damienmaguire/Nissan-Leaf-Inverter-Controller/Leaf_Inv_Controller_V1_BOM.ods

Nissan Leaf Inverter Controller V1 BOM
Ref Name | Qty | Component | Value | Manufacturer | MPN | RS Part Number | Mouser Part Number | Description
D3,4,5,6 | 4 | 1N4148WS-7-F |  | Diodes Inc. | 1N4148WS-7-F | 9228070 |  | Diode Switching 150mA 75V 200mW SOD323 Diodes Inc 1N4148WS-7-F Switching Diode, 150mA 75V, 2-Pin SOD-323
CONN3,5 | 2 | 3WAY_SIL |  | AMPHENOL FCI | 77311-401-36LF | 771-0189 |  | Board-To-Board Connector, 2.54 mm, 36 Contacts, Header, BergStik 77311 Series, Through Hole, 1 Rows
CONN1 | 1 | 75867-101LF |  | 75867101LF | FCI | 75867-101LF | 6737635 | 10w R/A T/H boxed header Quickie Amphenol FCI Quickie Series, 2.54mm Pitch 10 Way 2 Row Shrouded Right Angle PCB Header, Through Hole
CONN2 | 1 | 5787834-1 |  | TE Connectivity | 5787834-1 | 5298224 |  | USB type B vertical thru-hole socket
CONN4 | 1 | Cinch |  | Cinch | 5810132011 |  | 538-581-01-32-011 | Automotive Connectors MODICE ME-MX 32 POSITION
L1 | 1 | 7447709470 |  | Wurth Elektronik | 7447709470 | 789-6805 |  | Surface Mount Power Inductor, WE-PD Series, 47 µH, 3.8 A, 4.5 A, Shielded, 0.06 ohm
IC1 | 1 | ATSAM3X/AAU | ATSAM3X8EA-AU | Microchip | ATSAM3X8EA-AU | 131-1191 | 556-ATSAM3X8EA-AU | ATSAM3X8EA-AU, 32bit ARM Cortex M3 Microcontroller, 84MHz, 512 kB Flash, 144-Pin LQFP
C2,4,5,6,7,8,9,11,14,15,16,18,19,20,21,22,23,32,106,107,65 | 21 | C-USC0805 | 0.1u | MURATA | GRM219R71C104KA01D | 790-0667 |  | 100nF Multilayer Ceramic Capacitor MLCC 16V dc ±10% X7R Dielectric 0805 (2012M)
C30 | 1 | C-USC0805 | 0.01u | AVX | 08055F103KAT2A | 698-3462 |  | 10nF Multilayer Ceramic Capacitor MLCC 50V dc ±10% X8R Dielectric 0805 (2012M)
C113,66,111,112,67,36,37,17 | 8 | C-USC0805 | 1uF | KEMET | C0805C105K4RACTU | 451-5770 |  | 1μF Multilayer Ceramic Capacitor MLCC 16V dc ±10% X7R Dielectric 0805 (2012M)
C1,10,12,13,24,31 | 6 | C-USC0805 | 10u | MURATA | GRM21BR61E106KA73L | 790-0673 |  | 10μF Multilayer Ceramic Capacitor MLCC 25V dc ±10% X5R Dielectric 0805 (2012M)
C27,28,29 | 3 | C-USC0805 | 22p | AVX | 08051A220JAT2A | 464-6587 |  | 22pF Multilayer Ceramic Capacitor MLCC 100V dc ±5% C0G Dielectric 0805 (2012M)
C105,108 | 2 | C-USC0805 | 47nF | AVX | 08055F473KAT2A | 698-3516 |  | 47nF Multilayer Ceramic Capacitor MLCC 50V dc ±10% X8R Dielectric 0805 (2012M)
C25,26 | 2 | C-USC1206 | 22p | AVX | 12061A220JAT2A | 136-4302 |  | AVX 22pF Multilayer Ceramic Capacitor (MLCC) 100V dc ±5% 1206 (3216M)
C3 | 1 | Cap_el | 100uF | RSPRO | 711-0703 | 711-0703 |  | Aluminium Electrolytic Capacitor 100μF 6.3V dc 5mm Through Hole
Y1 | 1 | CRYSTAL-3.2-2.5 | 12MHz KX-7 20pF | ECS | ECS-120-20-33-CKM-TR |  | 520-120-20-33-CKMT | Crystals 12.000MHz 20pF 10ppm -20C +70C
C38 | 1 | ECA1AAD221X | 220uF 10V | Panasonic | ECA1AAD221X | 7270786P |  | Panasonic 220uF 10V dc Aluminium Electrolytic Capacitor, Through Hole 8 (Dia.) x 5mm +85C 8mm 0.5mm
C35 | 1 | EEU-FM1E681 | 680uF 35V | Panasonic | EEU-FM1E681 |  |  | PANASONIC ELECTRONIC COMPONENTS - EEU-FM1E681 - \94DD\7535\89E3\7535\5BB9, 680UF, 25V, \5F84\5411\5F15\7EBF
S1,S2 | 2 | EVQPE505K |  | Panasonic | EVQPE505K | 7561565 |  | Tact switch,THT,SPST,black,1.6N op force Black Push Plate Tactile Switch, SPST-NO 50 mA 5mm
LD1 | 1 | LD1117SOT223 | LD1117-3.3 | STMICROELECTRONICS | LD1117S33CTR | 686-9388 |  | LD1117S33CTR, LDO Regulator, 1.3A, 3.3 V, ±1% 3+Tab-Pin, SOT-223
LED1,2 | 1 | LED0805 |  | Wurth Elektronik | 150080SS75000 | 815-4234 |  | Wurth Elektronik 150080SS75000, WL-SMCW 630 nm Red LED, 2012 (0805) Clear SMD package
IC6 | 1 | LM2596S-5.0_NOPB |  | Texas Instruments | LM2596S-5.0/NOPB | 5333692 |  | SIMPLE SWITCHER 4.5V to 40V, 3A Low Component Count Step-Down Regulator
IC7 | 1 | M24M02-DRMN6TP |  | STMicroelectronics | M24M02-DRMN6TP | 8805333 |  | STMicroelectronics M24M02-DRMN6TP EEPROM Memory, 2Mbit, 450ns, 1.8 5.5 V 8-Pin SOIC
D1,2 | 1 | MBRS540T3G |  | ON Semiconductor | MBRS540T3G | 1250012 |  | Diode Schottky 40V 5A SMC ON Semiconductor MBRS540T3G Schottky Diode, 5A, 40V, 2-Pin SMC
IC5,IC8,IC9 | 3 | NCV8401ADTRKG |  | ON Semiconductor | NCV8401ADTRKG | 8079877 |  | Power Load Distribution Switch IC, Low Side, 1 Output, ± 14 V in, 16 A, 0.034 ohm
R73,74,75,76 | 4 | R-US_R0805 | 1K | RSPRO | 804-6449 | 804-6449 |  | Thick Film Surface Mount Fixed Resistor 0805 Case 1kΩ ±1% 0.125W
R15,17,23 | 3 | R-US_R0805 | 1K5 | RSPRO | RS-0805-1k5 | 713-6954 |  | Thick Film Surface Mount Fixed Resistor 0805 Case 1.5kΩ ±5% 0.125W
R6 | 1 | R-US_R0805 | 2K7 | RSPRO | 804-6486 | 804-6486 |  | Thick Film Surface Mount Fixed Resistor 0805 Case 2.7kΩ ±1% 0.125W
R14,16,18,19,22 | 5 | R-US_R0805 | 4K7 | RSPRO | RS-0805-4k7 | 713-6998 |  | Thick Film Surface Mount Fixed Resistor 0805 Case 4.7kΩ ±5% 0.125W
R4 | 1 | R-US_R0805 | 6k8 1% | RSPRO | 804-6515 | 804-6515 |  | Thick Film Surface Mount Fixed Resistor 0805 Case 6.8kΩ ±1% 0.125W
R8 | 1 | R-US_R0805 | 22K | RSPRO | 804-6546 | 804-6546 |  | Thick Film Surface Mount Fixed Resistor 0805 Case 22kΩ ±1% 0.125W
R2,3 | 2 | R-US_R0805 | 39R | RSPRO | 804-6335 | 804-6335 |  | Thick Film Surface Mount Fixed Resistor 0805 Case 39Ω ±1% 0.125W
R69,70,71,72 | 4 | R-US_R0805 | 60R4 | RSPRO | RS-0805-60R4 | 717-2130 |  | Thick Film Surface Mount Fixed Resistor 0805 Case 60.4Ω ±1% 0.125W
R1 | 1 | R-US_R0805 | 100k | RSPRO | 804-6607 | 804-6607 |  | Thick Film Surface Mount Fixed Resistor 0805 Case 100kΩ ±1% 0.125W
R5,13 | 2 | R-US_R0805 | 390R | RSPRO | RS-0805-390R | 713-6907 |  | Thick Film Surface Mount Fixed Resistor 0805 Case 390Ω ±5% 0.125W
Y2 | 1 | RESONATOR_EPSON_FC_145 | 32.768Khz | EPSON TOYOCOM | FC-135 32.768KHz 20ppm, 7pF | 667-6094 |  | SMD Crystal 32.768kHz, ±20ppm, 2-Pin, 3.2 x 1.5 x 0.8mm
IC3,4 | 2 | SN65HVD234 | SN65HVD234 | Texas Instruments | SN65HVD234D | 662-4315 |  | SN65HVD234D, CAN Transceiver 1MBps 1-channel ISO 11898
R20,21 | 1 | VARISTORCN0603 | CG0603MLC-05E | Bourns | CG0603MLC-05E | 851-8256 |  | MLC Series Power Varistor 0.5pF, Clamping 20V 0603 (1608M)
L2,3,4,5 | 4 | WE-CBF_0805 | MH2029-300Y | Bourns | MH2029-300Y |  | 652-MH2029-300Y | Ferrite Beads 30 ohms 25% HIGH CURRENT
Cinch Enclosure | 1 |  |  | Cinch | 5810130065 |  | 538-581-01-30-065 | Connector Accessory, Enclosure, Cinch ModICE SE Series Modular Connector Enclosures
