damienmaguire/Nissan-Leaf-Inverter-Controller/Leaf_VCU_V1 - Schematic.pdf

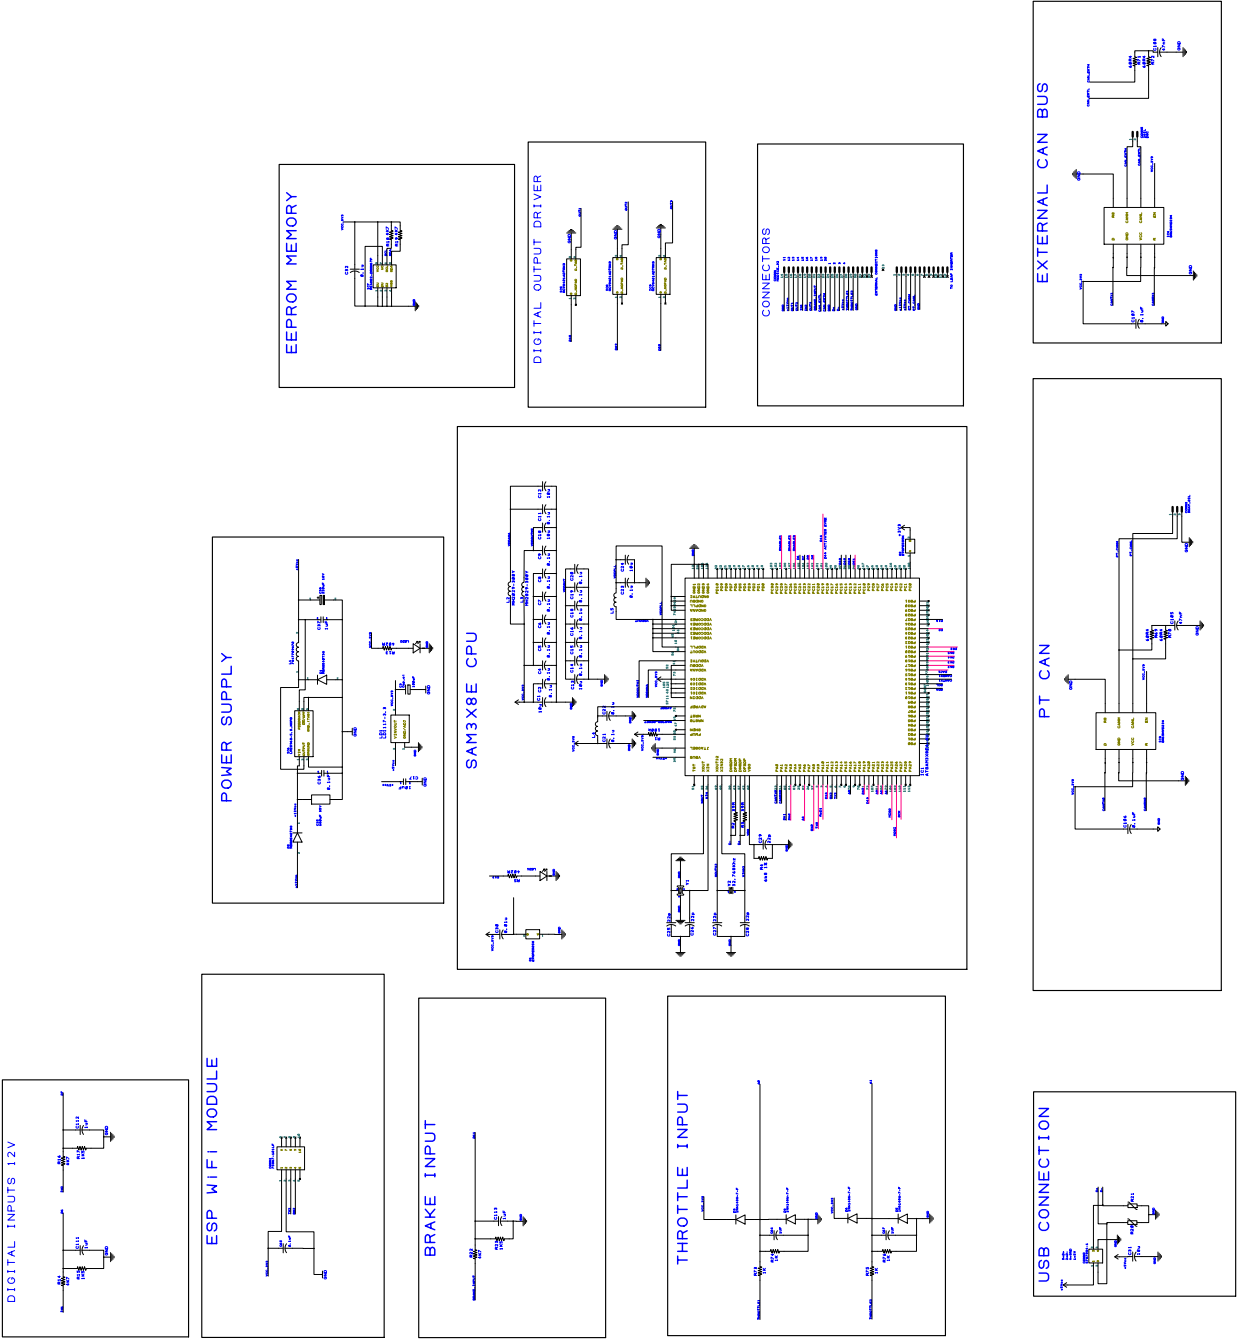
[picture p1: page 1]
