damienmaguire/Nissan-Leaf-Inverter-Controller/Leaf_VCU_V1 - PCB.pdf

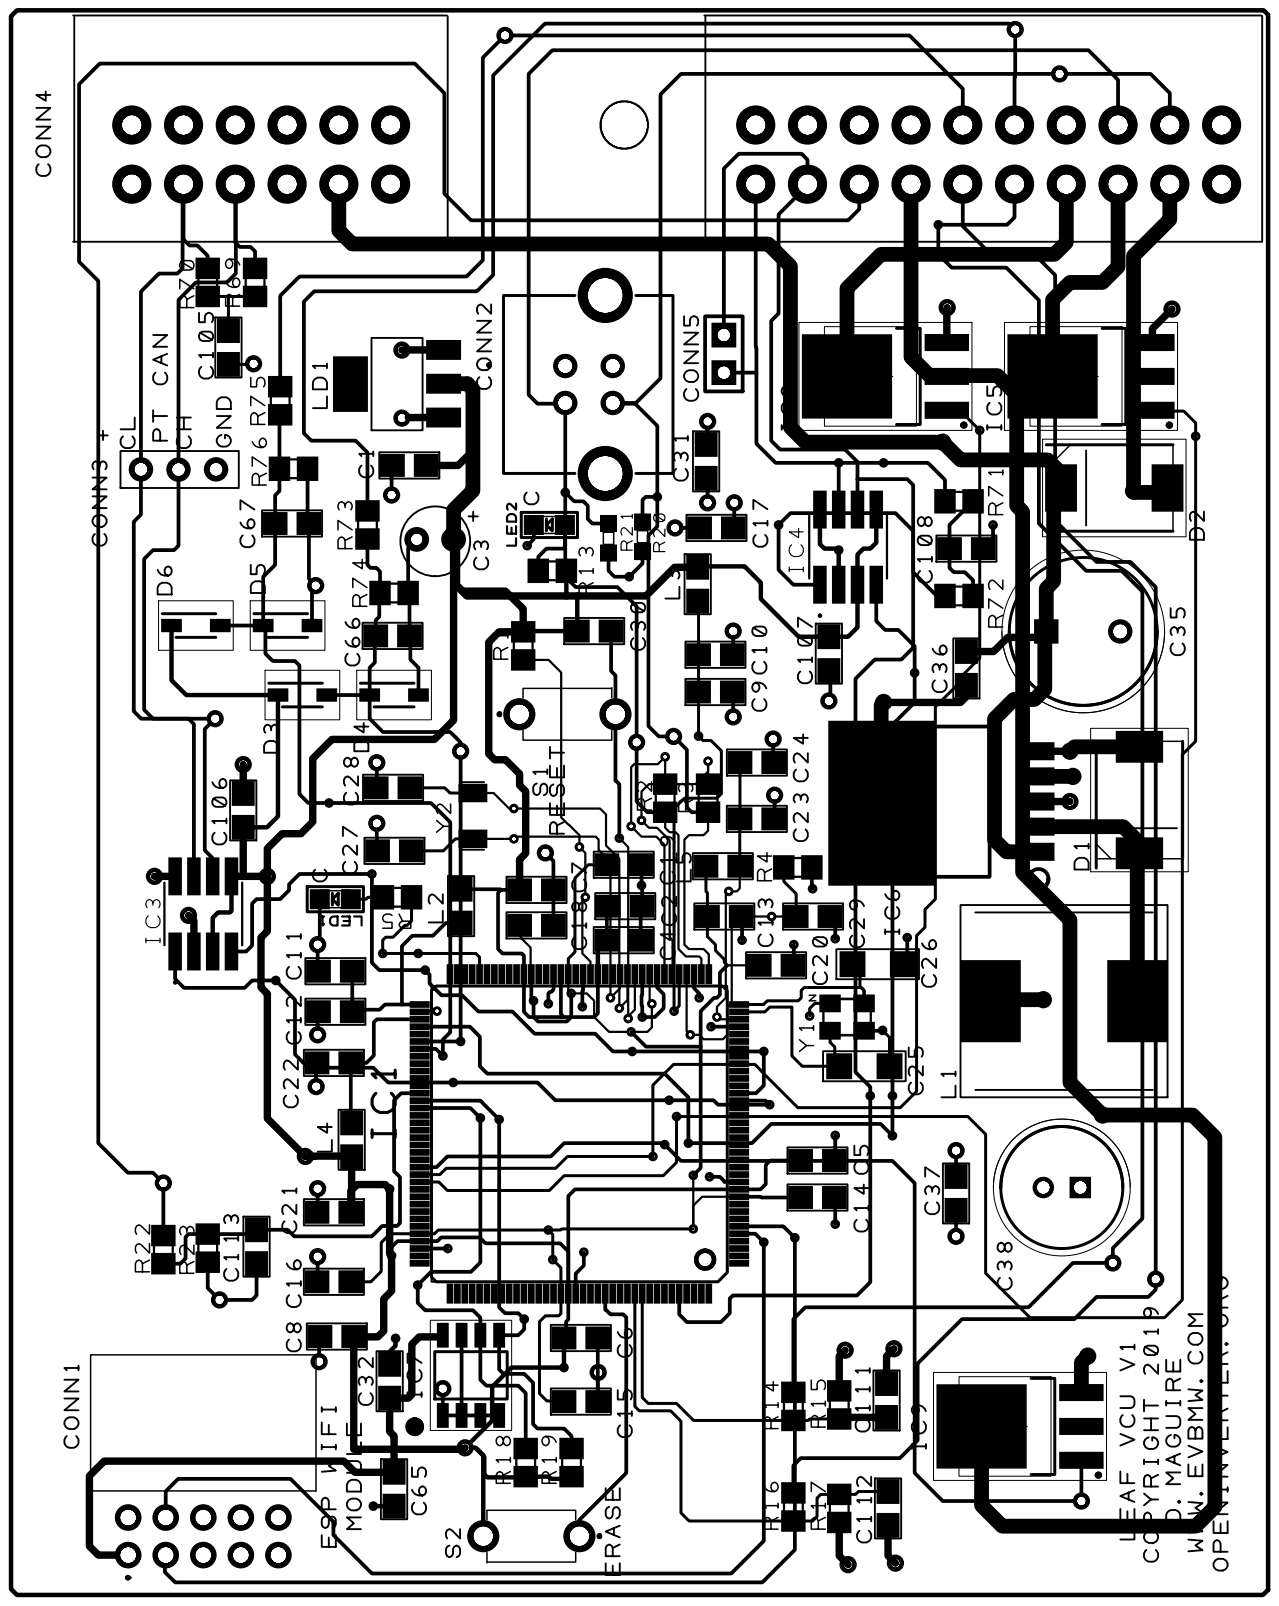
[picture p2: page 1]
