damienmaguire/Nissan-Leaf-Inverter-Controller/(list of files, drawings)

Other design files:
Leaf_VCU_V1.pcb
