damienmaguire/Nissan-Leaf-Inverter-Controller/(threads)

Thread 1 (2019-12-13):

How to connect the gas pedal.

kodzintm, 2019-12-13:
Hello.
Please let me know how the accelerator pedal is connected. What's the year of production?
I was looking to buy but there are at least two types.
Greetings
Tomek

JamesN52E01, 2020-09-20:
There are many options of gas/throttle pedal you just need a signal range of between 0-4v. The pinout explains how the pedal should be connected. You can adjust the code to match the voltage range/sweep of your throttle pedal. For more information on this visit: https://openinverter.org/forum/viewtopic.php?f=4&t=158

Thread 3 (2021-04-07):

Inverter Board PinOut

on4ip, 2021-04-07:
Hi.Thx for grate work. I have leaf inverter AZ0 and looking custom board to replace inverter board.
I want to know standart pinout of inverter board with PWM signal and current signals, but in ur documets Inverter board pinout looks like connection to VCU. Is it correct?

damienmaguire, 2021-04-07:
Please use the support thread on the Openinverter Forum for technical questions :
https://openinverter.org/forum/viewtopic.php?f=4&t=179

Thread 4 (2021-11-11):

newb

pxoxpxex, 2021-11-11:
obviously i cant copy/paste this code straight to an arduino...so how do i do it?
im aware how dumb this question must seem

dalathegreat, 2021-11-11:
1st step is to get a CAN-MITM bridge, it has the required CAN chips on it. A standard Arduino needs additional components if you want it acting as a CAN-MITM device.

Shoot me a PM or email if you want to purchase a board (info@dalasevrepair.fi)

Thread 5 (2022-03-12):

Not Spinning

andrewacid, 2022-03-12:
Gen2 ...not spinning. Using TJA1050 and arduino due. 48,49,50 all high (define HVPreset 290 ) . Im not using any relays, just a HV switch, and a 12VDC switch. Throttle1 on A2 connected with pot; Gnd-A2-3.3V .  Leaf_Gen1_5.ino
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

Closed 2022-03-13.

Thread 6 (2022-03-16):

Forward-Reverse-Slow

andrewacid, 2022-03-16:
Awesome code, got my ZE0 gen2 EM57 spinning! On my motor the inverter and resolver must be connected, so I had to get the factory wiring loom before it would work.

I used a potentiometer for throttle , with averaging and capacitors in an attempt to get a solid reading.

So, my questions are:

1/ How do you switch from Forward-Reverse?

2/  How do you keep motor spinning at low RPM? If there is no/small load on the motor, reducing the ThrotVal via the analogRead/potentiometer doesnt slow the motor, it keeps spinning the same speed...
