damienmaguire/Nissan-Leaf-Inverter-Controller/Software/Leaf_Gen1_5.ino

/*
Leaf Gen1 Inverter driver. Alpha software for testing.
Runs on the Arduino Due SAM3X8E MCU. V1 Leaf open source vcu.
Enter torque request on serial window.
As of now only responds to negative torque requests. e.g. -10
Positive torque requests trigger the inverter pwm but do not rotate the motor.

V5 incorporates ISA can shunt on CAN0. Let's hope the leaf inverter doesnt mind the isa messages and vice versa:)
WiFi on Serial2.
Precharge control : out1 = precharge , out2= main contactor


Copyright 2019 
Perttu Ahola (all the hard work!)
http://productions.8dromeda.net/c55-leaf-inverter-protocol.html

Damien Maguire (copy and paste).
OpenSource VCU hardware design available on Github :
https://github.com/damienmaguire/Nissan-Leaf-Inverter-Controller

2011 Nisan Leaf Gen 1 EV CAN logs on Github:
https://github.com/damienmaguire/LeafLogs


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


*/
#include <Metro.h>
#include <due_can.h>  
#include <due_wire.h> 
#include <DueTimer.h>  
#include <Wire_EEPROM.h> 
#include <ISA.h>  //isa can shunt library



#define Serial SerialUSB
template<class T> inline Print &operator <<(Print &obj, T arg) { obj.print(arg); return obj; }


CAN_FRAME outFrame;  //A structured variable according to due_can library for transmitting CAN data.
CAN_FRAME inFrame;    //structure to keep inbound inFrames

//////timers//////////////////////////////
Metro timer_Frames10 = Metro(10);
Metro timer_Frames100 = Metro(100);
Metro timer_wifi = Metro(1100);
Metro timer_hv = Metro(1000);


int inv_volts_local;
int16_t final_torque_request = 0;
#define INVERTER_BITS_PER_VOLT 2
#define INVERTER_BITS_PER_RPM 2


////////////////////Pin Map////////////////////////////////////////////////////
int led = 13;         //onboard led for diagnosis
#define Throttle1 A0  //Analog throttle channel 1
#define Throttle2 A1  //Analog throttle channel 2
#define Brake 61      //Brake pedal switch. High = brake on
#define IN1 6         //General purpose digital input 1. High =12v
#define IN2 7         //General purpose digital input 2. High =12v
#define OUT1  48      //Low side switched general purpose digital output 1. high = on.
#define OUT2  49      //Low side switched general purpose digital output 2. high = on.
#define OUT3  50      //Low side switched general purpose digital output 3. high = on.
/////////////////////////////////////////////////////////////////////////////////

#define HVPreset 340 //voltage at which to enable main contactor

uint16_t ThrotVal =0; //analog value of throttle position.
uint16_t outRPM;      //calculated value of rpm for e46 ike
static int16_t MaxTrq=2000;  //max torque request
struct InverterStatus {
  uint16_t voltage = 0;
  int16_t speed = 0;
  int8_t inverter_temperature = 0;
  int8_t motor_temperature = 0;
  bool error_state = false;
} inverter_status;

String readString;
byte ABSMsg=0x11;
uint8_t tempValue; //value to send to e46 temp gauge.

bool T15Status; //flag to keep status of Terminal 15 from In1
bool can_status;  //flag for turning off and on can sending.
bool Pch_Flag;    //precharge status flag
bool HV_Flag;     //hv on flag

ISA Sensor;  //Instantiate ISA Module Sensor object to measure current and voltage 

void setup() 
  {
  Can0.begin(CAN_BPS_500K);   // Inverter CAN
  Can1.begin(CAN_BPS_500K);   // Vehicle CAN
  //Can0.watchFor(0x1da); //set message filter for inverter can. Note sure if I can use two seperate values here. it might just pick 1!
  Can0.watchFor();
  Can1.watchFor(0x1ff); //just a blank message to block receive from e46 messages.
    
    Serial.begin(115200);  //Initialize our USB port which will always be redefined as SerialUSB to use the Native USB port tied directly to the SAM3X processor.
    Serial2.begin(19200);  //Serial comms with ESP32 WiFi module on serial 2
   // Timer3.attachInterrupt(Msgs10ms).start(10000); // 10ms CAN Message Timer
   // Timer4.attachInterrupt(Msgs100ms).start(100000); //100ms CAN Message Timer
    
  pinMode(led, OUTPUT);
  pinMode(Brake, INPUT);
  pinMode(IN1, INPUT);  //T15 input from ign on switch
  pinMode(IN2, INPUT);
  pinMode(OUT1, OUTPUT);
  pinMode(OUT2, OUTPUT);
  pinMode(OUT3, OUTPUT);
  
  //digitalWrite(led, HIGH);
  digitalWrite(OUT1, LOW);  //precharge
  digitalWrite(OUT2, LOW);  //main contactor
  digitalWrite(OUT3, LOW);  //inverter power
  

 
  }

  
  
void loop()
{ 
Check_T15();  //is the ignition on?  
if (timer_hv.check()) HV_Con(); //control hv system
Msgs100ms();  //fire the 100ms can messages
Msgs10ms();   //fire the 10ms can messages
readPedals(); //read throttle and brake pedal status.
SendTorqueRequest();  //send torque request to inverter.
ProcessRPM(); //send rpm and temp to e46 instrument cluster
CheckCAN(); //check for incoming can
handle_wifi();  //send wifi data

}

void Check_T15()
{
if (digitalRead(IN1))
{
T15Status=true;
can_status=true;
}
else
{
T15Status=false;
can_status=false;
Pch_Flag=false;
HV_Flag=false;
inv_volts_local==0;
}

}

void HV_Con()
{

  inv_volts_local=(inverter_status.voltage / INVERTER_BITS_PER_VOLT);


if (T15Status && !Pch_Flag)  //if terminal 15 is on and precharge not enabled
{
  digitalWrite(OUT3, HIGH);  //inverter power on
  if(inv_volts_local<200)
  {
  digitalWrite(OUT1, HIGH);  //precharge on
  Pch_Flag=true;
  }
}
if (T15Status && !HV_Flag && Pch_Flag)  //using inverter measured hv for initial tests. Will use ISA derived voltage in final version.
{
  if (inv_volts_local>340)
  {
  digitalWrite(OUT2, HIGH);  //main contactor on
  HV_Flag=true;  //hv on flag
  }
}

if (!T15Status)
{
  digitalWrite(OUT1, LOW);  //precharge off
  digitalWrite(OUT2, LOW);  //main contactor off
  digitalWrite(OUT3, LOW);  //inverter power off
  
}

}

void handle_wifi(){
  if (timer_wifi.check())
  {
/*
 * 
 * Routine to send data to wifi on serial 2
The information will be provided over serial to the esp8266 at 19200 baud 8n1 in the form :
vxxx,ixxx,pxxx,mxxxx,oxxx,rxxx* where :

v=pack voltage (0-700Volts)
i=current (0-1000Amps)
p=power (0-300kw)
m=motor rpm (0-10000rpm)
o=motor temp (-20 to 120C)
r=inverter temp (-20 to 120C)
*=end of string
xxx=three digit integer for each parameter eg p100 = 100kw.
updates will be every 1100ms approx.

v100,i200,p35,m3000,o20,r100*
*/
  
//Serial2.print("v100,i200,p35,m3000,o20,r100*"); //test string

digitalWrite(13,!digitalRead(13));//blink led every time we fire this interrrupt.
      Serial.print(inv_volts_local);
      Serial.print(F(" Volts"));
      Serial.println();
      Serial.println(HV_Flag);

Serial2.print("v");//dc bus voltage
Serial2.print(Sensor.Voltage);//voltage derived from ISA shunt
Serial2.print(",i");//dc current
Serial2.print(Sensor.Amperes);//current derived from ISA shunt
Serial2.print(",p");//total motor power
Serial2.print(Sensor.KW);//Power value derived from ISA Shunt
Serial2.print(",m");//motor rpm
Serial2.print(inverter_status.speed);
Serial2.print(",o");//motor temp
Serial2.print(inverter_status.motor_temperature);
Serial2.print(",r");//inverter temp
Serial2.print(inverter_status.inverter_temperature);
Serial2.print("*");// end of data indicator
  }
}

  



void Msgs10ms()                       //10ms messages here
{
if(timer_Frames10.check())
{
  if(can_status)
  {
    
  
  static uint8_t counter_11a_d6 = 0;
  static uint8_t counter_1d4 = 0;
  static uint8_t counter_1db = 0;
   static uint8_t counter_329 = 0;
    static uint8_t counter_100ms = 0;

  // Send VCM gear selection signal (gets rid of P3197)
  

        outFrame.id = 0x11a;            // Set our transmission address ID
        outFrame.length = 8;            // Data payload 3 bytes
        outFrame.extended = 0;          // Extended addresses - 0=11-bit 1=29bit
        outFrame.rtr=1;                 //No request



    
 //   CAN_FRAME inFrame;
  //  inFrame.id = 0x11a;
  //  inFrame.length = 8;

    // Data taken from a gen1 inFrame where the car is starting to
    // move at about 10% throttle: 4E400055 0000017D

    // All possible gen1 values: 00 01 0D 11 1D 2D 2E 3D 3E 4D 4E
    // MSB nibble: Selected gear (gen1/LeafLogs)
    //   0: some kind of non-gear before driving
    //   1: some kind of non-gear after driving
    //   2: R
    //   3: N
    //   4: D
    // LSB nibble: ? (LeafLogs)
    //   0: sometimes at startup, not always; never when the
    //      inverted is powered on (0.06%)
    //   1: this is the usual value (55% of the time in LeafLogs)
    //   D: seems to occur for ~90ms when changing gears (0.2%)
    //   E: this also is a usual value, but never occurs with the
    //      non-gears 0 and 1 (44% of the time in LeafLogs)


    
    outFrame.data.bytes[0] = 0x4E;
    //outFrame.data.bytes[0] = 0x01;

    // 0x40 when car is ON, 0x80 when OFF, 0x50 when ECO
    outFrame.data.bytes[1] = 0x40;

    // Usually 0x00, sometimes 0x80 (LeafLogs), 0x04 seen by canmsgs
    outFrame.data.bytes[2] = 0x00;

    // Weird value at D3:4 that goes along with the counter
    // NOTE: Not actually needed, you can just send constant AA C0
    const static uint8_t weird_d34_values[4][2] = {
      {0xaa, 0xc0},
      {0x55, 0x00},
      {0x55, 0x40},
      {0xaa, 0x80},
    };
    outFrame.data.bytes[3] = weird_d34_values[counter_11a_d6][0];
    outFrame.data.bytes[4] = weird_d34_values[counter_11a_d6][1];

    // Always 0x00 (LeafLogs, canmsgs)
    outFrame.data.bytes[5] = 0x00;

    // A 2-bit counter
    outFrame.data.bytes[6] = counter_11a_d6;

    counter_11a_d6++;
    if(counter_11a_d6 >= 4)
      counter_11a_d6 = 0;

    // Extra CRC
    nissan_crc(outFrame.data.bytes, 0x85);

    /*Serial.print(F("Sending "));
    print_fancy_inFrame(inFrame);
    Serial.println();*/

 Can0.sendFrame(outFrame);
 
    
  
  
  // Send target motor torque signal
  

        outFrame.id = 0x1d4;            // Set our transmission address ID
        outFrame.length = 8;            // Data payload 3 bytes
        outFrame.extended = 0;          // Extended addresses - 0=11-bit 1=29bit
        outFrame.rtr=1;                 //No request

    // Data taken from a gen1 inFrame where the car is starting to
    // move at about 10% throttle: F70700E0C74430D4

    // Usually F7, but can have values between 9A...F7 (gen1)
    outFrame.data.bytes[0] = 0xF7;
    // 2016: 6E
   // outFrame.data.bytes[0] = 0x6E;

    // Usually 07, but can have values between 07...70 (gen1)
    outFrame.data.bytes[1] = 0x07;
    // 2016: 6E
    //outFrame.data.bytes[1] = 0x6E;

    // Requested torque (signed 12-bit value + always 0x0 in low nibble)
    static int16_t last_logged_final_torque_request = 0;
    if(final_torque_request != last_logged_final_torque_request){
      last_logged_final_torque_request = final_torque_request;
      //log_print_timestamp();
      //Serial.print(F("Sending torque request "));
      //Serial.print(final_torque_request);
      //Serial.print(F(" (speed: "));
      //Serial.print(inverter_status.speed / INVERTER_BITS_PER_RPM);
      //Serial.print(F(" rpm)"));
      //Serial.print(inverter_status.voltage / INVERTER_BITS_PER_VOLT);
      //Serial.print(F(" Volts)"));
      //Serial.println();
    }
    if(final_torque_request >= -2048 && final_torque_request <= 2047){
      outFrame.data.bytes[2] = ((final_torque_request < 0) ? 0x80 : 0) |
          ((final_torque_request >> 4) & 0x7f);
      outFrame.data.bytes[3] = (final_torque_request << 4) & 0xf0;
    } else {
      outFrame.data.bytes[2] = 0x00;
      outFrame.data.bytes[3] = 0x00;
    }

    // MSB nibble: Runs through the sequence 0, 4, 8, C
    // LSB nibble: Precharge report (precedes actual precharge
    //             control)
    //   0: Discharging (5%)
    //   2: Precharge not started (1.4%)
    //   3: Precharging (0.4%)
    //   5: Starting discharge (3x10ms) (2.0%)
    //   7: Precharged (93%)
    outFrame.data.bytes[4] = 0x07 | (counter_1d4 << 6);
    //outFrame.data.bytes[4] = 0x02 | (counter_1d4 << 6);

    counter_1d4++;
    if(counter_1d4 >= 4)
      counter_1d4 = 0;

    // MSB nibble:
    //   0: 35-40ms at startup when gear is 0, then at shutdown 40ms
    //      after the car has been shut off (6% total)
    //   4: Otherwise (94%)
    // LSB nibble:
    //   0: ~100ms when changing gear, along with 11A D0 b3:0 value
    //      D (0.3%)
    //   2: Reverse gear related (13%)
    //   4: Forward gear related (21%)
    //   6: Occurs always when gear 11A D0 is 01 or 11 (66%)
    //outFrame.data.bytes[5] = 0x44;
    //outFrame.data.bytes[5] = 0x46;

    // 2016 drive cycle: 06, 46, precharge, 44, drive, 46, discharge, 06
    // 0x46 requires ~25 torque to start
    //outFrame.data.bytes[5] = 0x46;
    // 0x44 requires ~8 torque to start
    outFrame.data.bytes[5] = 0x44;

    // MSB nibble:
    //   In a drive cycle, this slowly changes between values (gen1):
    //     leaf_on_off.txt:
    //       5 7 3 2 0 1 3 7
    //     leaf_on_rev_off.txt:
    //       5 7 3 2 0 6
    //     leaf_on_Dx3.txt:
    //       5 7 3 2 0 2 3 2 0 2 3 2 0 2 3 7
    //     leaf_on_stat_DRDRDR.txt:
    //       0 1 3 7
    //     leaf_on_Driveincircle_off.txt:
    //       5 3 2 0 8 B 3 2 0 8 A B 3 2 0 8 A B A 8 0 2 3 7 
    //     leaf_on_wotind_off.txt:
    //       3 2 0 8 A B 3 7
    //     leaf_on_wotinr_off.txt:
    //       5 7 3 2 0 8 A B 3 7
    //     leaf_ac_charge.txt:
    //       4 6 E 6
    //   Possibly some kind of control flags, try to figure out
    //   using:
    //     grep 000001D4 leaf_on_wotind_off.txt | cut -d' ' -f10 | uniq | ~/projects/leaf_tools/util/hex_to_ascii_binary.py
    //   2016:
    //     Has different values!
    // LSB nibble:
    //   0: Always (gen1)
    //   1:  (2016)

    // 2016 drive cycle:
    //   E0: to 0.15s
    //   E1: 2 messages
    //   61: to 2.06s (inverter is powered up and precharge
    //                 starts and completes during this)
    //   21: to 13.9s
    //   01: to 17.9s
    //   81: to 19.5s
    //   A1: to 26.8s
    //   21: to 31.0s
    //   01: to 33.9s
    //   81: to 48.8s
    //   A1: to 53.0s
    //   21: to 55.5s
    //   61: 2 messages
    //   60: to 55.9s
    //   E0: to end of capture (discharge starts during this)

    // This value has been chosen at the end of the hardest
    // acceleration in the wide-open-throttle pull, with full-ish
    // torque still being requested, in
    //   LeafLogs/leaf_on_wotind_off.txt
    //outFrame.data.bytes[6] = 0x00;

    // This value has been chosen for being seen most of the time
    // when, and before, applying throttle in the wide-open-throttle
    // pull, in
    //   LeafLogs/leaf_on_wotind_off.txt
    outFrame.data.bytes[6] = 0x30;    //brake applied heavilly.

    // Value chosen from a 2016 log
    //outFrame.data.bytes[6] = 0x61;

    // Value chosen from a 2016 log
    // 2016-24kWh-ev-on-drive-park-off.pcap #12101 / 15.63s
   // outFrame.data.bytes[6] = 0x01;
    //byte 6 brake signal

    // Extra CRC
    nissan_crc(outFrame.data.bytes, 0x85);

    /*Serial.print(F("Sending "));
    print_fancy_inFrame(inFrame);
    Serial.println();*/

 Can0.sendFrame(outFrame);

//We need to send 0x1db here with voltage measured by inverter

        outFrame.id = 0x1db;            // Set our transmission address ID
        outFrame.length = 8;            // Data payload 3 bytes
        outFrame.extended = 0;          // Extended addresses - 0=11-bit 1=29bit
        outFrame.rtr=1;                 //No request
        outFrame.data.bytes[0]=0x00;  
        outFrame.data.bytes[1]=0x00;
        outFrame.data.bytes[2]=0x00;
        outFrame.data.bytes[3]=0x00;
        outFrame.data.bytes[4]=0x00;
        outFrame.data.bytes[5]=0x00;
        outFrame.data.bytes[6]=counter_1db;
        outFrame.data.bytes[7]=0x00;


    counter_1db++;
    if(counter_1db >= 4)
      counter_1db = 0;

        

        Can0.sendFrame(outFrame);

///////////////Originally sent as 100ms messages.///////////////////////////////////////////

  

        outFrame.id = 0x50b;            // Set our transmission address ID
        outFrame.length = 7;            // Data payload 8 bytes
        outFrame.extended = 0;          // Extended addresses - 0=11-bit 1=29bit
        outFrame.rtr=1;                 //No request
    // Statistics from 2016 capture:
    //     10 00000000000000
    //     21 000002c0000000
    //    122 000000c0000000
    //    513 000006c0000000

    // Let's just send the most common one all the time
    // FIXME: This is a very sloppy implementation
  //  hex_to_data(outFrame.data.bytes, "00,00,06,c0,00,00,00");
        outFrame.data.bytes[0]=0x00;
        outFrame.data.bytes[1]=0x00;  
        outFrame.data.bytes[2]=0x06;
        outFrame.data.bytes[3]=0xc0;
        outFrame.data.bytes[4]=0x00;
        outFrame.data.bytes[5]=0x00;
        outFrame.data.bytes[6]=0x00;

    /*CONSOLE.print(F("Sending "));
    print_fancy_inFrame(inFrame);
    CONSOLE.println();*/
        Can0.sendFrame(outFrame); 

/////////////////////////////////////////////////////////////////////////////////////////////////////


//these messages go out on vehicle can and are specific to driving the E46 instrument cluster etc.

//////////////////////DME Messages //////////////////////////////////////////////////////////

        outFrame.id = 0x316;            // Set our transmission address ID
        outFrame.length = 8;            // Data payload 8 bytes
        outFrame.extended = 0;          // Extended addresses - 0=11-bit 1=29bit
        outFrame.rtr=1;                 //No request
        outFrame.data.bytes[0]=0x05;
        outFrame.data.bytes[1]=0x00;
        outFrame.data.bytes[2]=lowByte(outRPM);  //RPM LSB
        outFrame.data.bytes[3]=highByte(outRPM);  //RPM MSB [RPM=(hex2dec("byte3"&"byte2"))/6.4]  0x12c0 should be 750rpm on tach
       // outFrame.data.bytes[2]=0xc0;  //RPM LSB
       // outFrame.data.bytes[3]=0x12;  //RPM MSB [RPM=(hex2dec("byte3"&"byte2"))/6.4]  0x12c0 should be 750rpm on tach
 //       outFrame.data.bytes[2]=0xff;  //RPM LSB
 //       outFrame.data.bytes[3]=0x4f;  //RPM MSB [RPM=(hex2dec("byte3"&"byte2"))/6.4]  0x4fff gives 3200rpm on tach
        outFrame.data.bytes[4]=0x00;
        outFrame.data.bytes[5]=0x00;
        outFrame.data.bytes[6]=0x00;
        outFrame.data.bytes[7]=0x00;
        Can1.sendFrame(outFrame);


/////////////////////////////////////////////////////////////////////////////////////////////////////////////////////////////////        


  //********************temp sense  *******************************
 // tempValue=analogRead(tempIN); //read Analog pin voltage
//  The sensor and gauge are not linear.  So if the sensed 
//  Voltage is less than the mid point the Map function
//  is used to map the input values to output values For the gauge
//  output values (in decimal):
//  86 = First visible movment of needle starts
//  93 = Begining of Blue section
//  128 = End of Blue Section
//  169 = Begin Straight up
//  193 = Midpoint of needle straight up values
//  219 = Needle begins to move from center
//  230 = Beginning of Red section
//  254 = needle pegged to the right
// MAP program statement: map(value, fromLow, fromHigh, toLow, toHigh)

 // if(tempValue < 964){  //if pin voltage < mid point value 
tempValue= inverter_status.inverter_temperature;  //read temp from leaf inverter can.
tempValue= map(tempValue,15,80,88,254); //Map to e46 temp gauge
 //   }
//  else {
 //   tempValue= map(tempValue,964,1014,219,254); //Map upper half of range
 // }

//Can bus data packet values to be sent
        outFrame.id = 0x329;            // Set our transmission address ID
        outFrame.length = 8;            // Data payload 8 bytes
        outFrame.extended = 0;          // Extended addresses - 0=11-bit 1=29bit
        outFrame.rtr=1;                 //No request
        outFrame.data.bytes[0]=ABSMsg;  //needs to cycle 11,86,d9
        outFrame.data.bytes[1]=tempValue; //temp bit tdata 
        outFrame.data.bytes[2]=0xc5;
        outFrame.data.bytes[3]=0x00;
        outFrame.data.bytes[4]=0x00;
        outFrame.data.bytes[5]=0x00; //Throttle position currently just fixed value
        outFrame.data.bytes[6]=0x00;
        outFrame.data.bytes[7]=0x00;
        Can1.sendFrame(outFrame);


    counter_329++;
    if(counter_329 >= 22) counter_329 = 0;
    if(counter_329==0) ABSMsg=0x11;
    if(counter_329==8) ABSMsg=0x86;
    if(counter_329==15) ABSMsg=0xd9;
   
    



//From ECU, MPG, MIL, overheat light, Cruise
// ErrorState variable controls:
//Check engine(binary 10), Cruise (1000), EML (10000)
//Temp light Variable controls temp light.  Hex 08 is on zero off


  //**************** set Error Lights & cruise light ******
 // hex 08 = Overheat light on
//  // hex 08 = Overheat light on
 //Set check engine. Binary 0010 (hex 02)
// No error light (zero)


 // int z = 0x60; // + y;  higher value lower MPG


//Can bus data packet values to be sent
        outFrame.id = 0x545;            // Set our transmission address ID
        outFrame.length = 8;            // Data payload 8 bytes
        outFrame.extended = 0;          // Extended addresses - 0=11-bit 1=29bit
        outFrame.rtr=1;                 //No request
        outFrame.data.bytes[0]=0x00;  //2=check ewwngine on , 0=check engine off
        outFrame.data.bytes[1]=0x00; //LSB fuel comp
        outFrame.data.bytes[2]=0x00;  //MSB fuel comp
        outFrame.data.bytes[3]=0x00;   // hex 08 = Overheat light on
        outFrame.data.bytes[4]=0x7E;
        outFrame.data.bytes[5]=0x10; 
        outFrame.data.bytes[6]=0x00;
        outFrame.data.bytes[7]=0x18;
        Can1.sendFrame(outFrame);



}
}
 
    }
    



void Msgs100ms()                      ////100ms messages here
{
if(timer_Frames100.check())
{
  if(can_status)
   {

//  digitalWrite(led, !digitalRead(led)); //toggle led everytime we fire the 100ms messages.

        outFrame.id = 0x50b;            // Set our transmission address ID
        outFrame.length = 7;            // Data payload 8 bytes
        outFrame.extended = 0;          // Extended addresses - 0=11-bit 1=29bit
        outFrame.rtr=1;                 //No request
    // Statistics from 2016 capture:
    //     10 00000000000000
    //     21 000002c0000000
    //    122 000000c0000000
    //    513 000006c0000000

    // Let's just send the most common one all the time
    // FIXME: This is a very sloppy implementation
  //  hex_to_data(outFrame.data.bytes, "00,00,06,c0,00,00,00");
        outFrame.data.bytes[0]=0x00;
        outFrame.data.bytes[1]=0x00;  
        outFrame.data.bytes[2]=0x06;
        outFrame.data.bytes[3]=0xc0;
        outFrame.data.bytes[4]=0x00;
        outFrame.data.bytes[5]=0x00;
        outFrame.data.bytes[6]=0x00;

    /*CONSOLE.print(F("Sending "));
    print_fancy_inFrame(inFrame);
    CONSOLE.println();*/
        Can0.sendFrame(outFrame); 
}
}      
}



void readPedals()
{
ThrotVal = analogRead(Throttle1); //read throttle channel 1 directly
ThrotVal = constrain(ThrotVal, 145, 620);
ThrotVal = map(ThrotVal, 145, 620, 0, MaxTrq); //will need to work here for cal.
if(ThrotVal<0) ThrotVal=0;  //no negative numbers for now.
if(digitalRead(Brake)) ThrotVal=0;  //if brake is pressed we zero the throttle value.
//Serial.println(ThrotVal);   //print for calibration. 
}



void SendTorqueRequest()
{

final_torque_request = ThrotVal;  //send mapped throttle signal to inverter.  
  
}



void ProcessRPM() //here we convert motor rpm values received from the leaf inverter into BMW E46 RPM can message.
{
outRPM = (inverter_status.speed)*6.4;
if(outRPM<4800) outRPM=4800;  //set lowest rpm to 750 displayed on tach to keep car alive thinking engine is running.
if(outRPM>44800) outRPM=44800;  //DONT READ MORE THAN 7000RPM!
//Serial.println(outRPM);  
}




static int8_t fahrenheit_to_celsius(uint16_t fahrenheit)
{
  int16_t result = ((int16_t)fahrenheit - 32) * 5 / 9;
  if(result < -128)
    return -128;
  if(result > 127)
    return 127;
  return result;
}

void CheckCAN()
{

///////////////////////////////////////////////////////////////////////////////////////////////////////////
//read incomming data from inverter//////////////////
//////////////////////////////////////////////////////
  if(Can0.available())
  {
    Can0.read(inFrame);
    //Serial.println(inFrame.id, HEX);
  

  if(inFrame.id == 0x1da && inFrame.length == 8){
  //  last_received_from_inverter_timestamp = millis();

    inverter_status.voltage = ((uint16_t)inFrame.data.bytes[0] << 2) |
        (inFrame.data.bytes[1] >> 6);

    int16_t parsed_speed = ((uint16_t)inFrame.data.bytes[4] << 8) |
        (uint16_t)inFrame.data.bytes[5];
    inverter_status.speed = (parsed_speed == 0x7fff ? 0 : parsed_speed);

    inverter_status.error_state = (inFrame.data.bytes[6] & 0xb0) != 0x00;
  }

  if(inFrame.id == 0x55a && inFrame.length == 8){
   // last_received_from_inverter_timestamp = millis();

    inverter_status.inverter_temperature = fahrenheit_to_celsius(inFrame.data.bytes[2]);
    inverter_status.motor_temperature = fahrenheit_to_celsius(inFrame.data.bytes[1]);
    //Serial.println(inverter_status.inverter_temperature);
  }

  }

////////////////////////////////////////////////////////////////////////////////////////////////

  
}

static void nissan_crc(uint8_t *data, uint8_t polynomial)
{
  // We want to process 8 bytes with the 8th byte being zero
  data[7] = 0;
  uint8_t crc = 0;
  for(int b=0; b<8; b++)
  {
    for(int i=7; i>=0; i--)
    {
      uint8_t bit = ((data[b] &(1 << i)) > 0) ? 1 : 0;
      if(crc >= 0x80) 
        crc = (byte)(((crc << 1) + bit) ^ polynomial);
      else 
        crc = (byte)((crc << 1) + bit);
    }
  }
  data[7] = crc;
}
